Aeasala/p5n5/fleuron.png

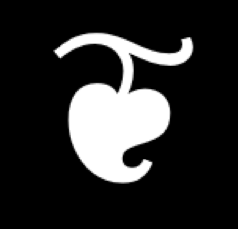
fleuron.png
