Aeasala/p5n5/Project Outputs for p5n5/BOM/Bill of Materials-p5n5.xlsx

Manufacturer | Part Number | Description | Designator | Footprint | Value | Quantity
KEMET | C0805C102J5RACTU | CAP CER 1000PF 50V X7R 0805 | C1, C2 | CAP 0805_2012 | 1000 pF | 2 | C0805C102J5RACTU | 2
KEMET | C0805C224K5RACTU | CAP CER 0.22UF 50V X7R 0805 | C3, C4 | CAP 0805_2012 | 0.22 µF | 2 | C0805C224K5RACTU | 2
TDK Corporation | CGA8P1X7R1E226M250KC | CAP CER 22UF 25V X7R 1812 | C5_N5V, C5_P5V, C6_N5V, C6_P5V, C7_N5V, C7_P5V, C8_N5V, C8_P5V | CAP 1812_4532 1.1MM | 22 µF | 8 | CGA8P1X7R1E226M250KC | 8
KEMET | C1206C475K5RACTU | CAP CER 4.7UF 50V X7R 1206 | C9, C10, C11, C12, C13, C14, C15, C16 | CAP 1206_3216 - 0.8MM | 4.7 µF | 8 | C1206C475K5RACTU | 8
KEMET | T491X686K025AT | CAP TANT 68UF 10% 25V 2917 | C17, C18, C19, C20 | CAP POL 2917_7343 | 68 µF | 4 | T491X686K025AT | 4
Visual Communications Company - VCC | CMD17-21VGD/TR8 | LED GREEN DIFFUSED 0805 SMD | D1 | LED 0805_2012 GREEN | Green | 1 | CMD17-21VGD/TR8 | 1
Visual Communications Company - VCC | CMD17-21VRD/TR8 | LED RED DIFFUSED 0805 SMD | D2 | LED 0805_2012 RED | Red | 1 | CMD17-21VRD/TR8 | 1
Nexperia USA Inc. | PMEG40T30ERX | DIODE SCHOTTKY 40V 3A SOD123W | D3 | SOD-123W |  | 1 | PMEG40T30ERX | 1
 |  |  | FD1, FD2, FD3 | FIDUCIAL |  | 3 | M20-7830642 | 3
Harwin Inc. | M20-7830642 | CONN RCPT 12POS 0.1 GOLD PCB | J1, J2, J4 | HARWIN M20-7830645 |  | 3 | 282834-2 | 1
TE Connectivity AMP Connectors | 282834-2 | TERM BLK 2P SIDE ENT 2.54MM PCB | J3 | TE 282834-2 |  | 1 | 7443634700 | 1
Würth Elektronik | 7443634700 | FIXED IND 47UH 12A 12.2 MOHM SMD | L1 | WURTH WE-HCF 14.5MM | 47 µH | 1 | BC817-40-7-F | 2
Diodes Incorporated | BC817-40-7-F | TRANS NPN 45V 0.5A SOT23-3 | Q1, Q2 | DIODES SOT-23-3 |  | 2 | ERA-8ARW4532V | 1
Panasonic Electronic Components | ERA-8ARW4532V | RES SMD 45.3KOHM 0.05% 1/4W 1206 | R1 | RES 1206_3216 | 45.3 kOhms | 1 | ERJ-PB6B2700V | 1
Panasonic Electronic Components | ERJ-PB6B2700V | RES SMD 270 OHM 0.1% 1/4W 0805 | R2 | RES 0805_2012 | 270 Ohms | 1 | TNPW080551K0BEEA | 1
Vishay Dale | TNPW080551K0BEEA | RES 51K OHM 0.1% 1/8W 0805 | R3 | RES 0805_2012 | 51 kOhms | 1 | TNPW08059K10BEEA | 1
Vishay Dale | TNPW08059K10BEEA | RES 9.1K OHM 0.1% 1/8W 0805 | R4 | RES 0805_2012 | 9.1 kOhms | 1 | RT0805FRE1310KL | 2
Yageo | RT0805FRE1310KL | RES 10K OHM 1% 1/8W 0805 | R6, R7 | RES 0805_2012 | 10 kOhms | 2 | ERA-8AEB8062V | 2
Panasonic Electronic Components | ERA-8AEB8062V | RES SMD 80.6K OHM 0.1% 1/4W 1206 | R8, R9 | RES 1206_3216 | 80.6 kOhms | 2 | RHC2512FT1R00 | 1
Stackpole Electronics Inc | RHC2512FT1R00 | RES 1 OHM 1% 2W 2512 | R10 | RES 2512_6432 | 1 Ohms | 1 | CRCW120647K0FKEA | 1
Vishay Dale | CRCW120647K0FKEA | RES SMD 47K OHM 1% 1/4W 1206 | R11 | RES 1206_3216 | 47 kOhms | 1 | RT1206FRE07150RL | 2
Yageo | RT1206FRE07150RL | RES SMD 150 OHM 1% 1/4W 1206 | R12, R13 | RES 1206_3216 | 150 Ohms | 2 | LTM8049IY | 1
Analog Devices Inc | LTM8049IY | No Description Available | U1 | LTM8049IY_ADI |  | 1
