Aeasala/p5n5/(threads)

Thread 4 (2023-08-04):

perform final spice analyses of project as a whole

Aeasala, 2023-08-04:
verify transient behavior of input filter w SMPS running.

verify stability of converter at various loads with selected amt of bulk capacitance

verify transient load switching/load regulation effect on input and output

monte carlo on input filter?  may be so overdamped that it doesn't matter

Aeasala, 2023-08-04:
Findings 1: pick different filtering inductance or larger input capacitance following it (still not damped enough for my liking)

Aeasala, 2023-08-04:
confirm feedback cap leading to N5V network

Aeasala, 2023-08-05:
Future todo: verify ""optimal"" switching frequency per datasheet for a +/- 5V output.

Closed 2023-08-05.

Thread 5 (2023-08-04):

add freewheeling diode to input inductor

Aeasala, 2023-08-04:
Inrush current to input filter appears to cause overshoot rel to supply voltage.  Flyback diode would clamp just over the supply voltage until settled.

In a second case, if the supply is suddenly disconnected while under load, back-EMF could destroy parts of the circuit.  Back EMF only seems that it would appear at the connector pin, rather than at the capacitor array -- still best-practice, though.

Aeasala, 2023-08-04:
diode should be rated for ~10A during the inrush.

Closed 2023-08-04.

Thread 6 (2023-08-04):

physical switch over run net

Aeasala, 2023-08-04:
To prevent inrush current faults.  3A current limit seems to not be enough for large input capacitance. before the 8049 attempts to begin running.

If physical switch isn't desired, increase SS1/2 delay.

Aeasala, 2023-08-05:
Soft start was increased to a 7.5-15ms margin

Closed 2023-08-05.

Thread 7 (2023-08-04):

Power rate damping resistor

Aeasala, 2023-08-04:
may need to parallel, need ~10W max over a 5ms period.  check pulse ratings

Aeasala, 2023-08-04:
parallelling would be good for the sake of transient response/parasitics

Aeasala, 2023-08-06:
Considering the duration of the inrush to these caps, this is nothing to worry about.  Would only be a problem if someone was connecting/DC-ing+shorting really fast repeatedly (which would be their problem if they broke it tbh)

Closed 2023-08-06.

Thread 15 (2023-08-05):

Fix some component spacing

Aeasala, 2023-08-05:
R1 is too close in proximity to R2/C1.  Confirm BGA dogbone drill size, pad size, spacing, tenting.

Move some (half of) decoupling caps towards the opposing VIN2/VIN1, whichever is which on the footprint?  Would require lopping off some of the P5V plane, as well as stitching a new GND plane in the empty region right of L1.

Closed 2023-08-06.

Thread 16 (2023-08-05):

Increase or verify copper clearance to board edge

Aeasala, 2023-08-05:
Received preliminary boards had copper uncomfortably close to board edge.

Aeasala, 2023-08-06:
This is a non-issue

Closed 2023-08-06.

Thread 18 (2023-08-05):

Pick alternate flyback diode

Aeasala, 2023-08-05:
mfr states part is obsolete.

Aeasala, 2023-08-05:
also, probably do not need DC current rating that high.  look into pulsed current rating.

Closed 2023-08-06.

Thread 30 (2023-08-15):

Audible coil whine under small load

Aeasala, 2023-08-15:
from umodule

Aeasala, 2023-09-05:
appears to be from my poor BGA soldering.  regardless, will create another issue to change switching frequency to the recommended 100 kHz for a bipolar 5V output.

Closed 2023-09-05.

Thread 33 (2023-08-15):

Replace fiducials with mounting holes

Aeasala, 2023-08-15:
Fiducials originally included as proof-of-concept.  Switch to mounting holes (+1 additional corner) for standoffs/pegs to elevate on a surface
