Aeasala/p5n5/Project Outputs for p5n5/Schematic.PDF

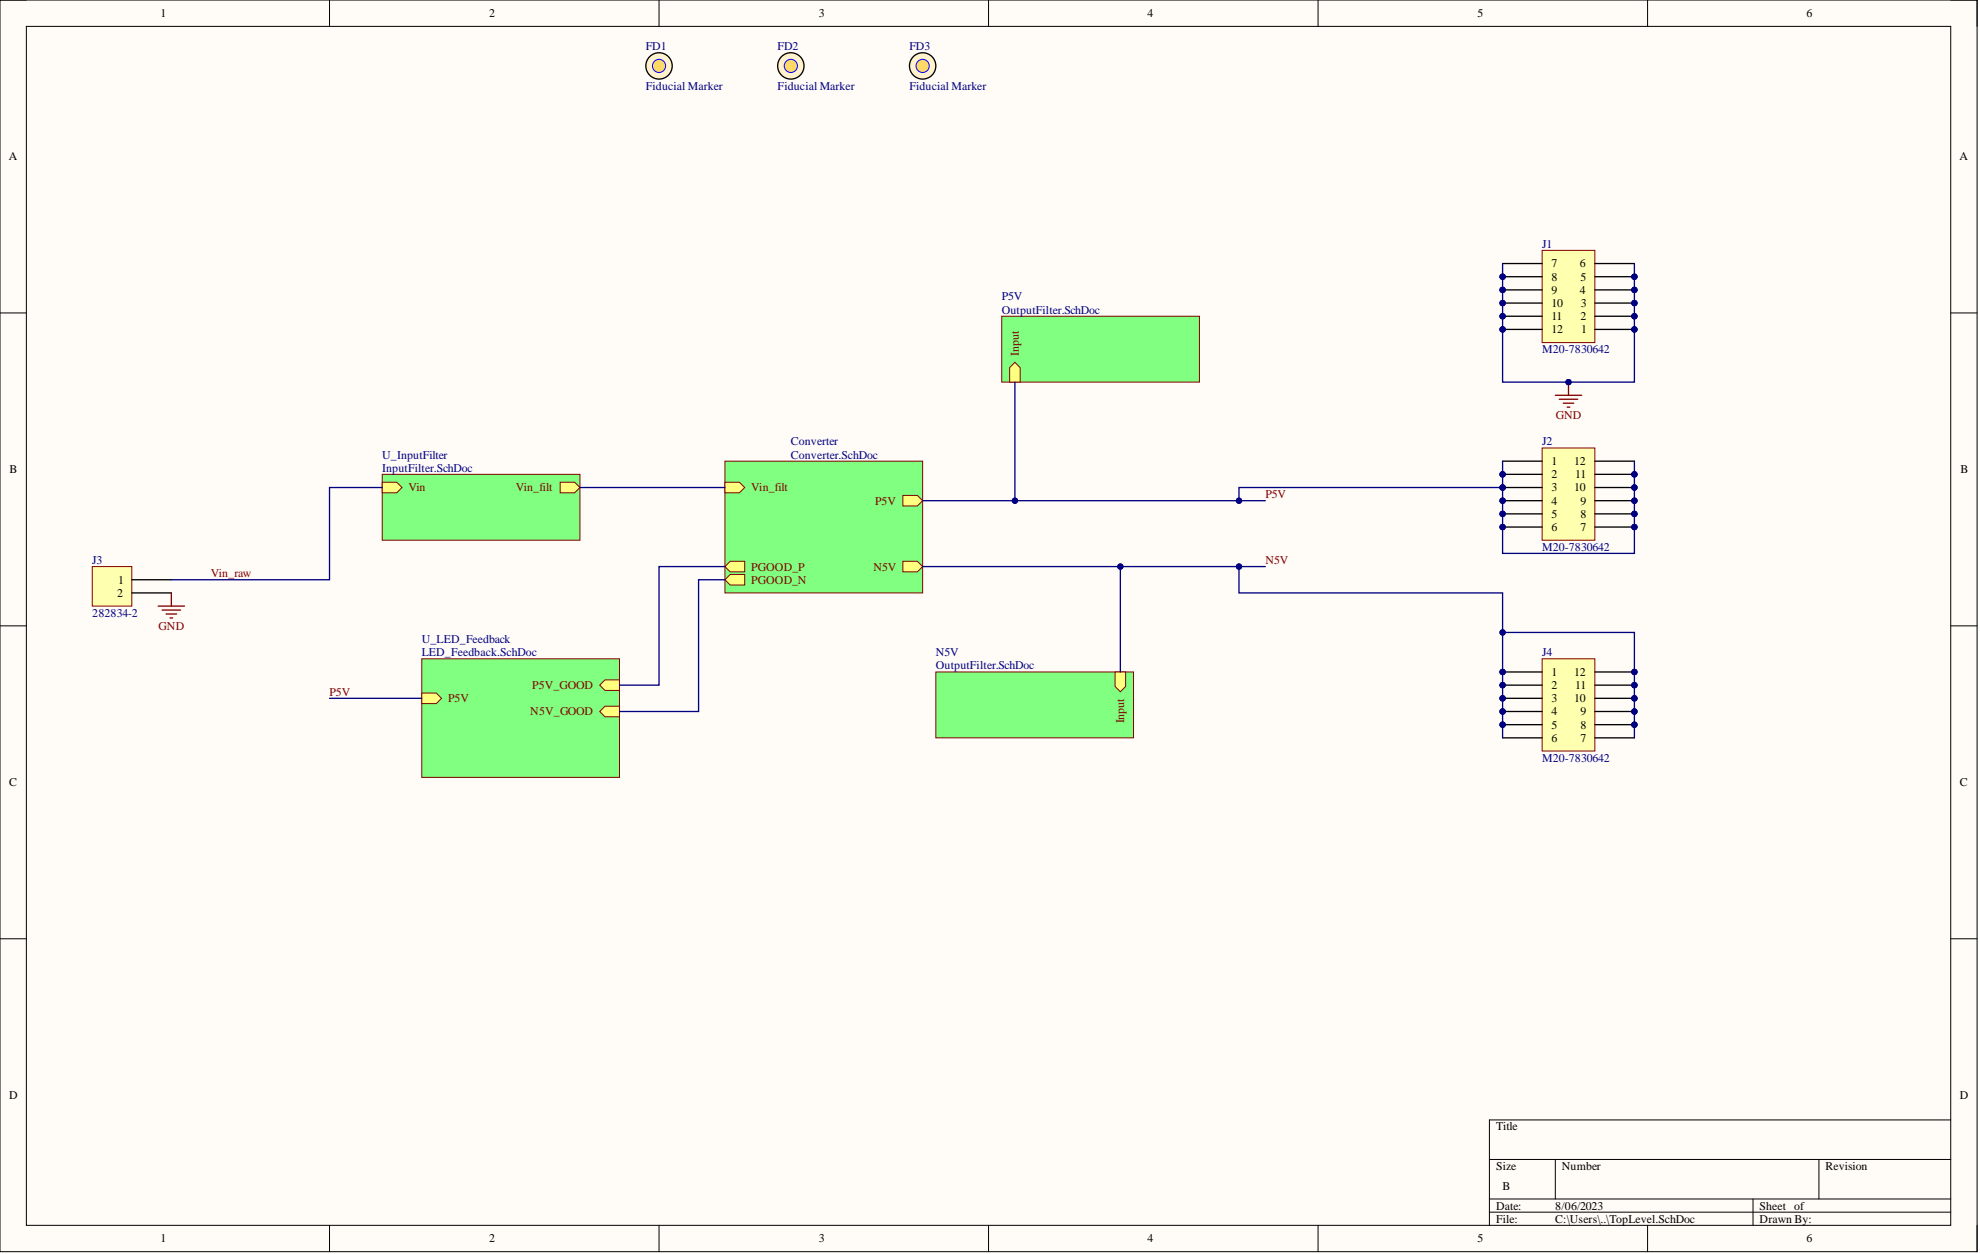
[picture p2: page 1]

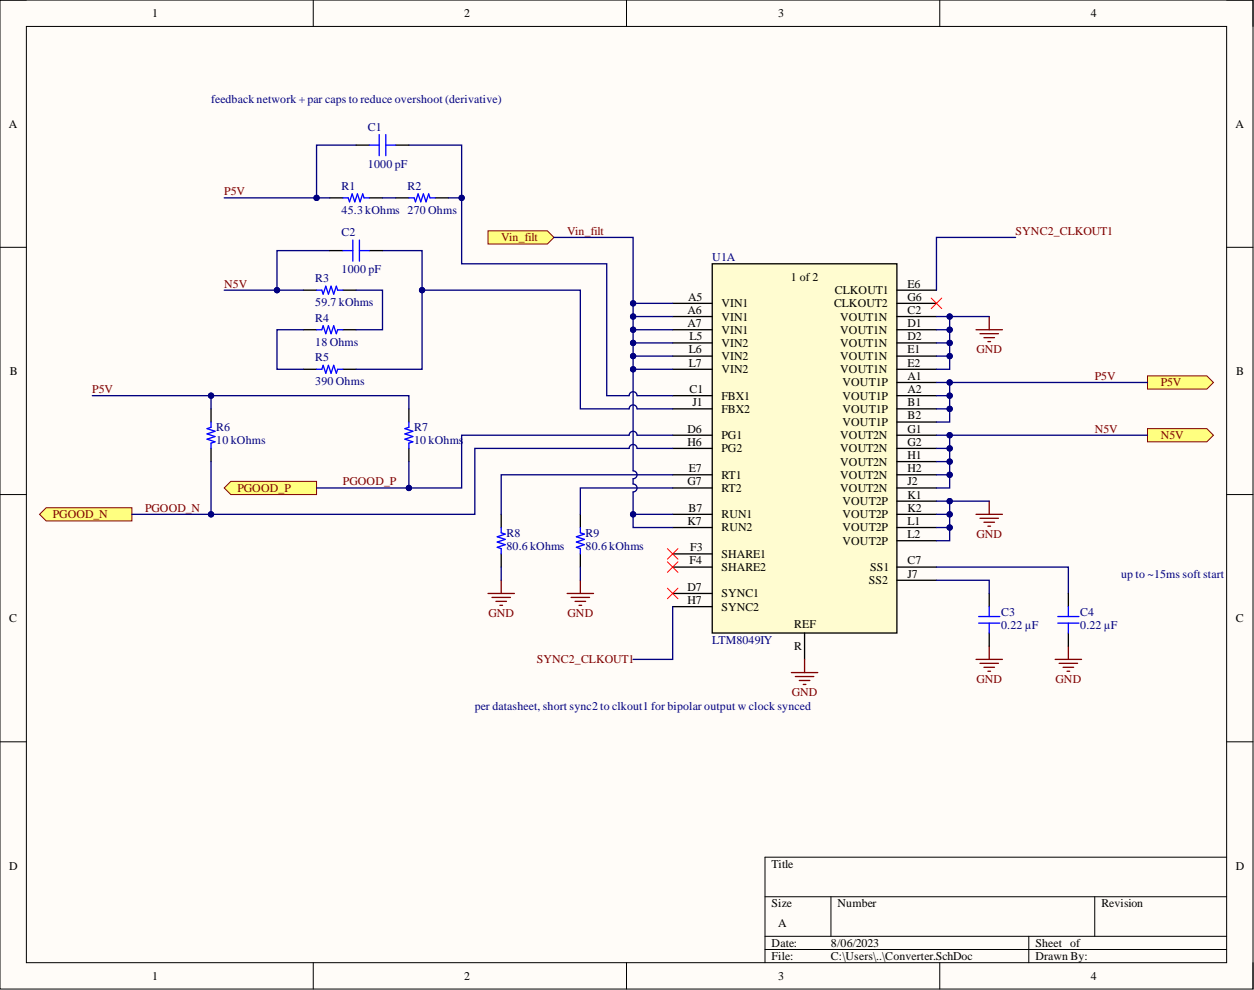
[picture p3: page 2]

feedback network + par caps to reduce overshoot (derivative)

VIN1 A6
VIN1 A7
VIN2 L5
VIN2 L6

RUN1 B7

per datasheet, short sync2 to clkout1 for bipolar output w clock synced

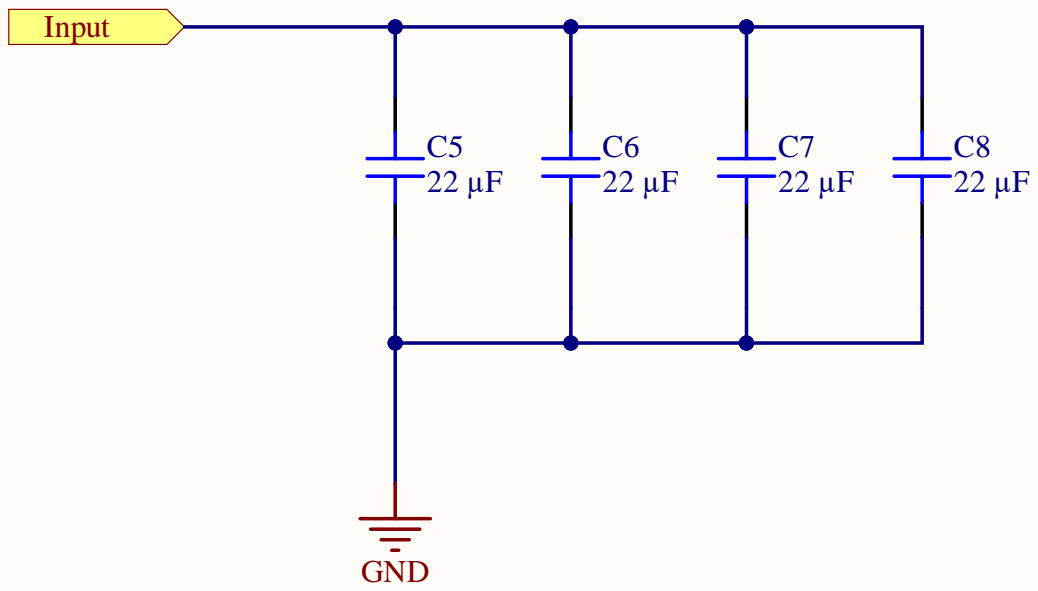
[picture p4: page 3]

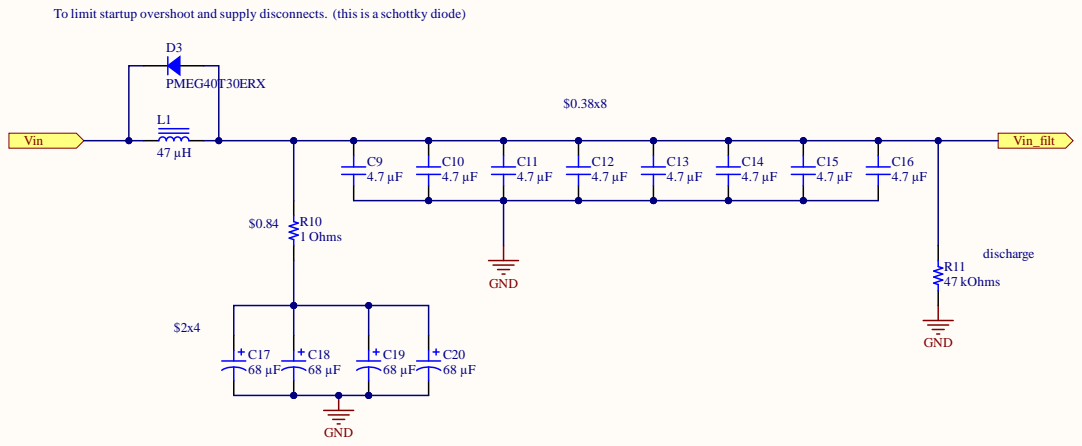
[picture p5: page 4]

To limit startup overshoot and supply disconnects. (this is a schottky diode)

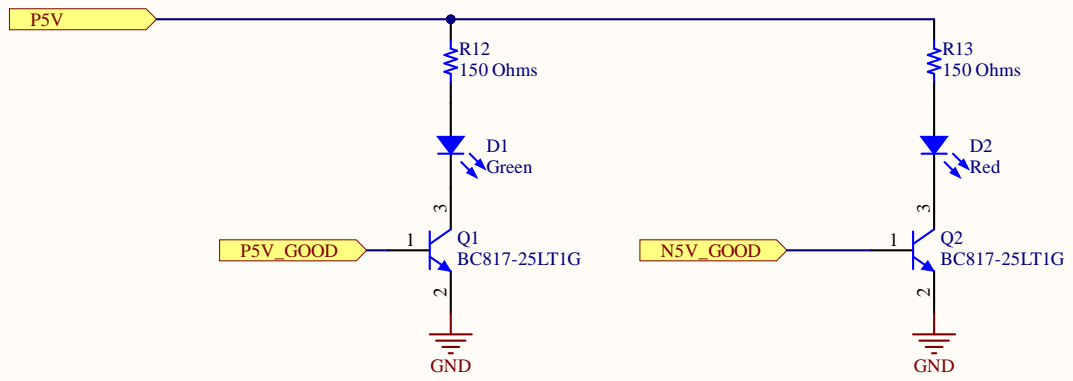
[picture p6: page 5]
