Aeasala/p5n5/Project Outputs for p5n5/PCB.PDF

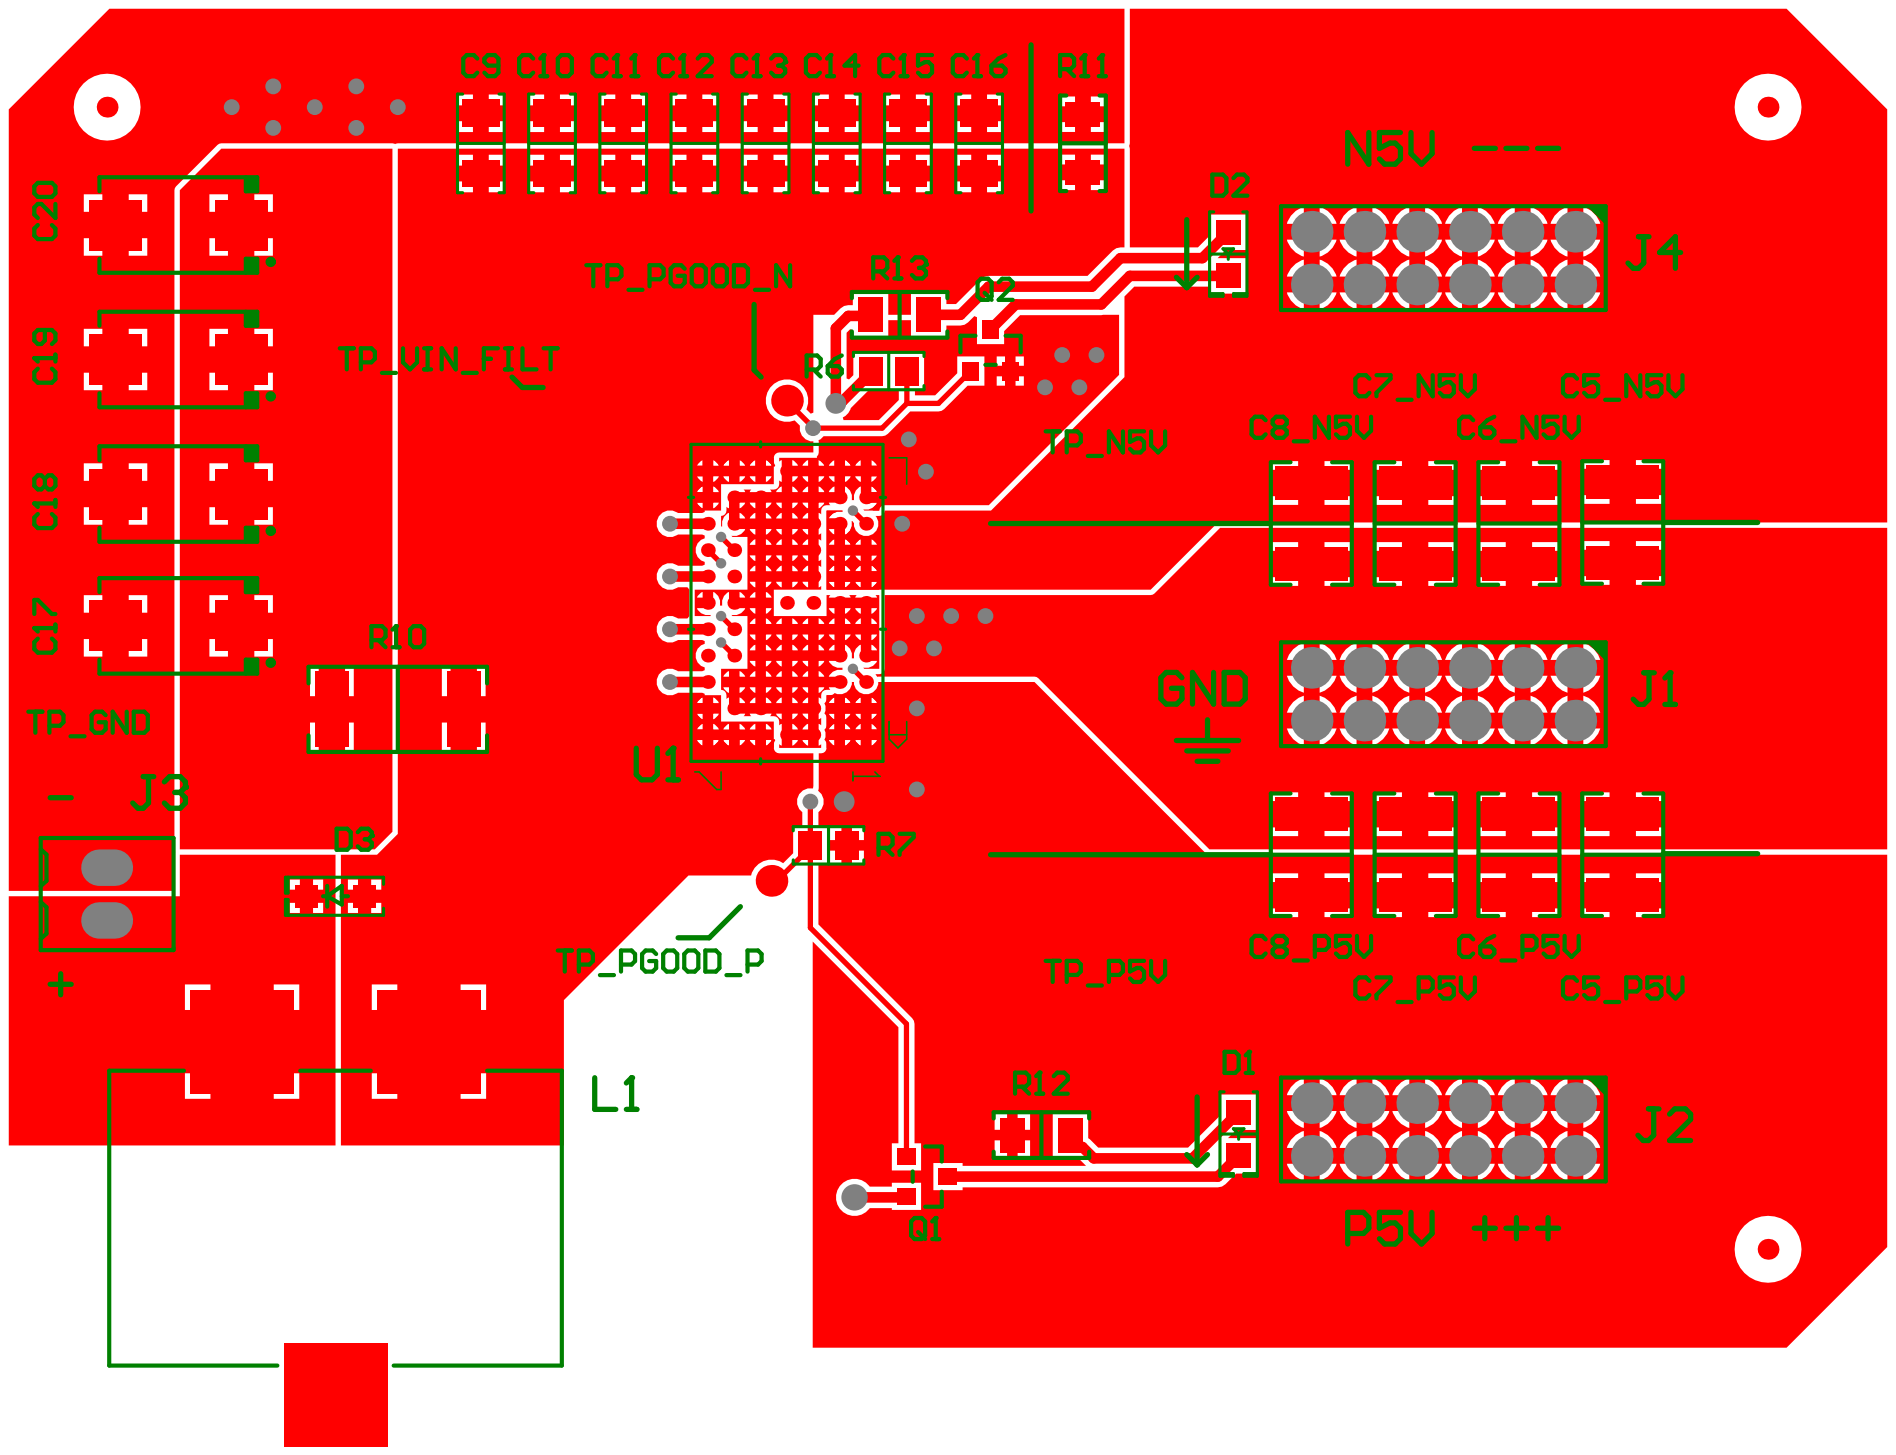
[picture p7: page 1]

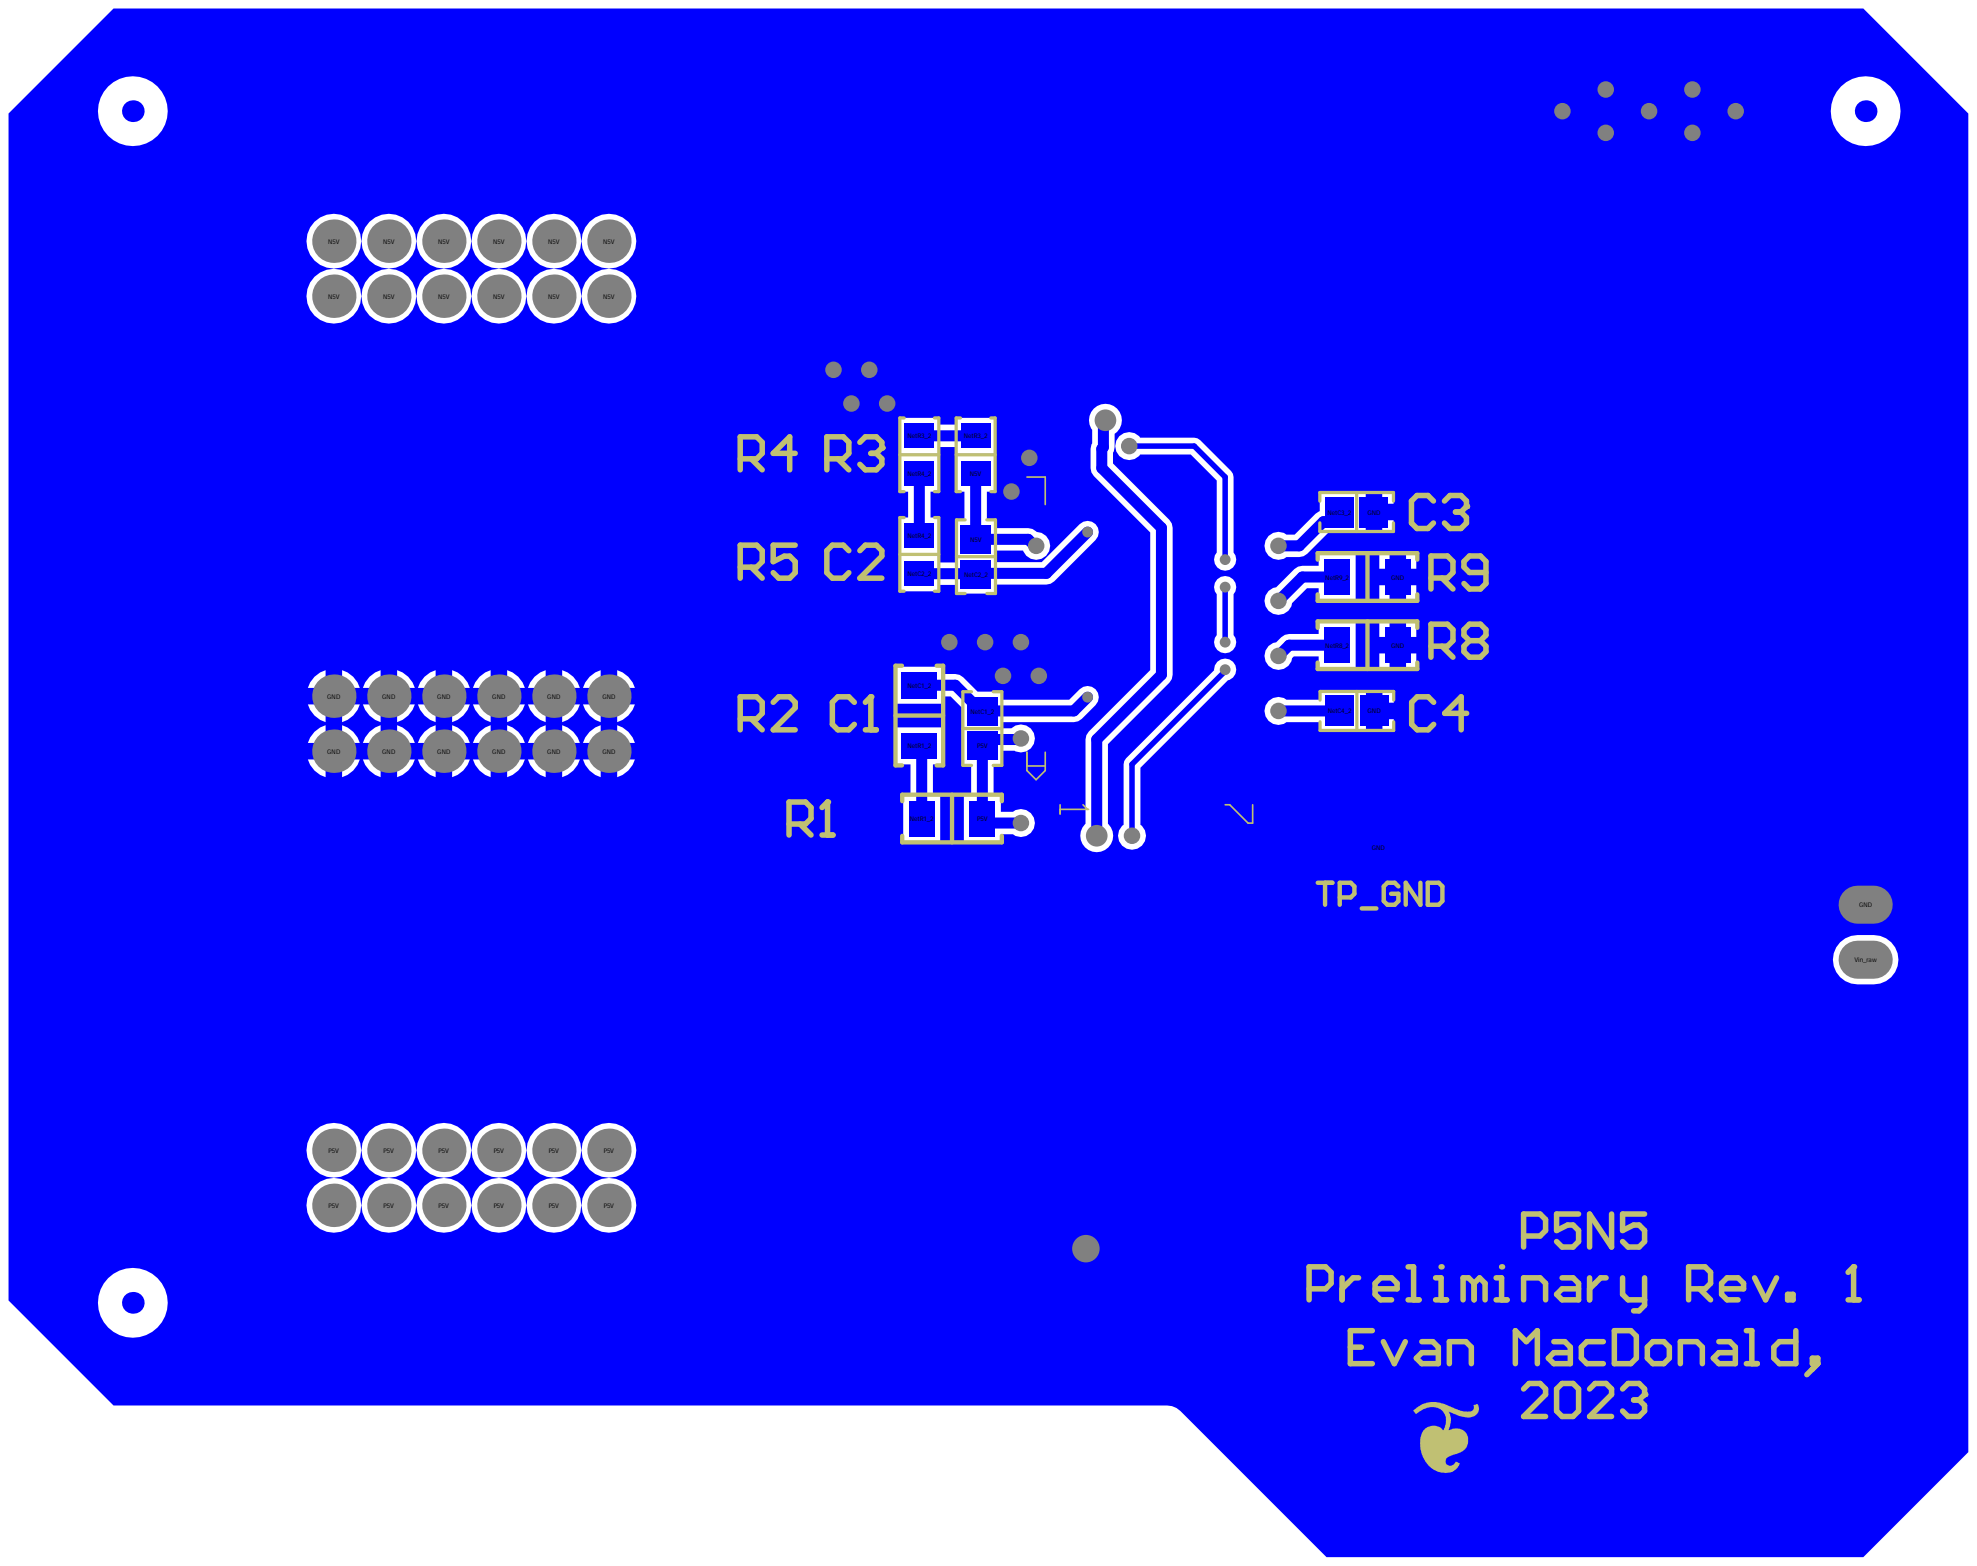
[picture p8: page 2]

NetC3_2 | GND

NetR4_2

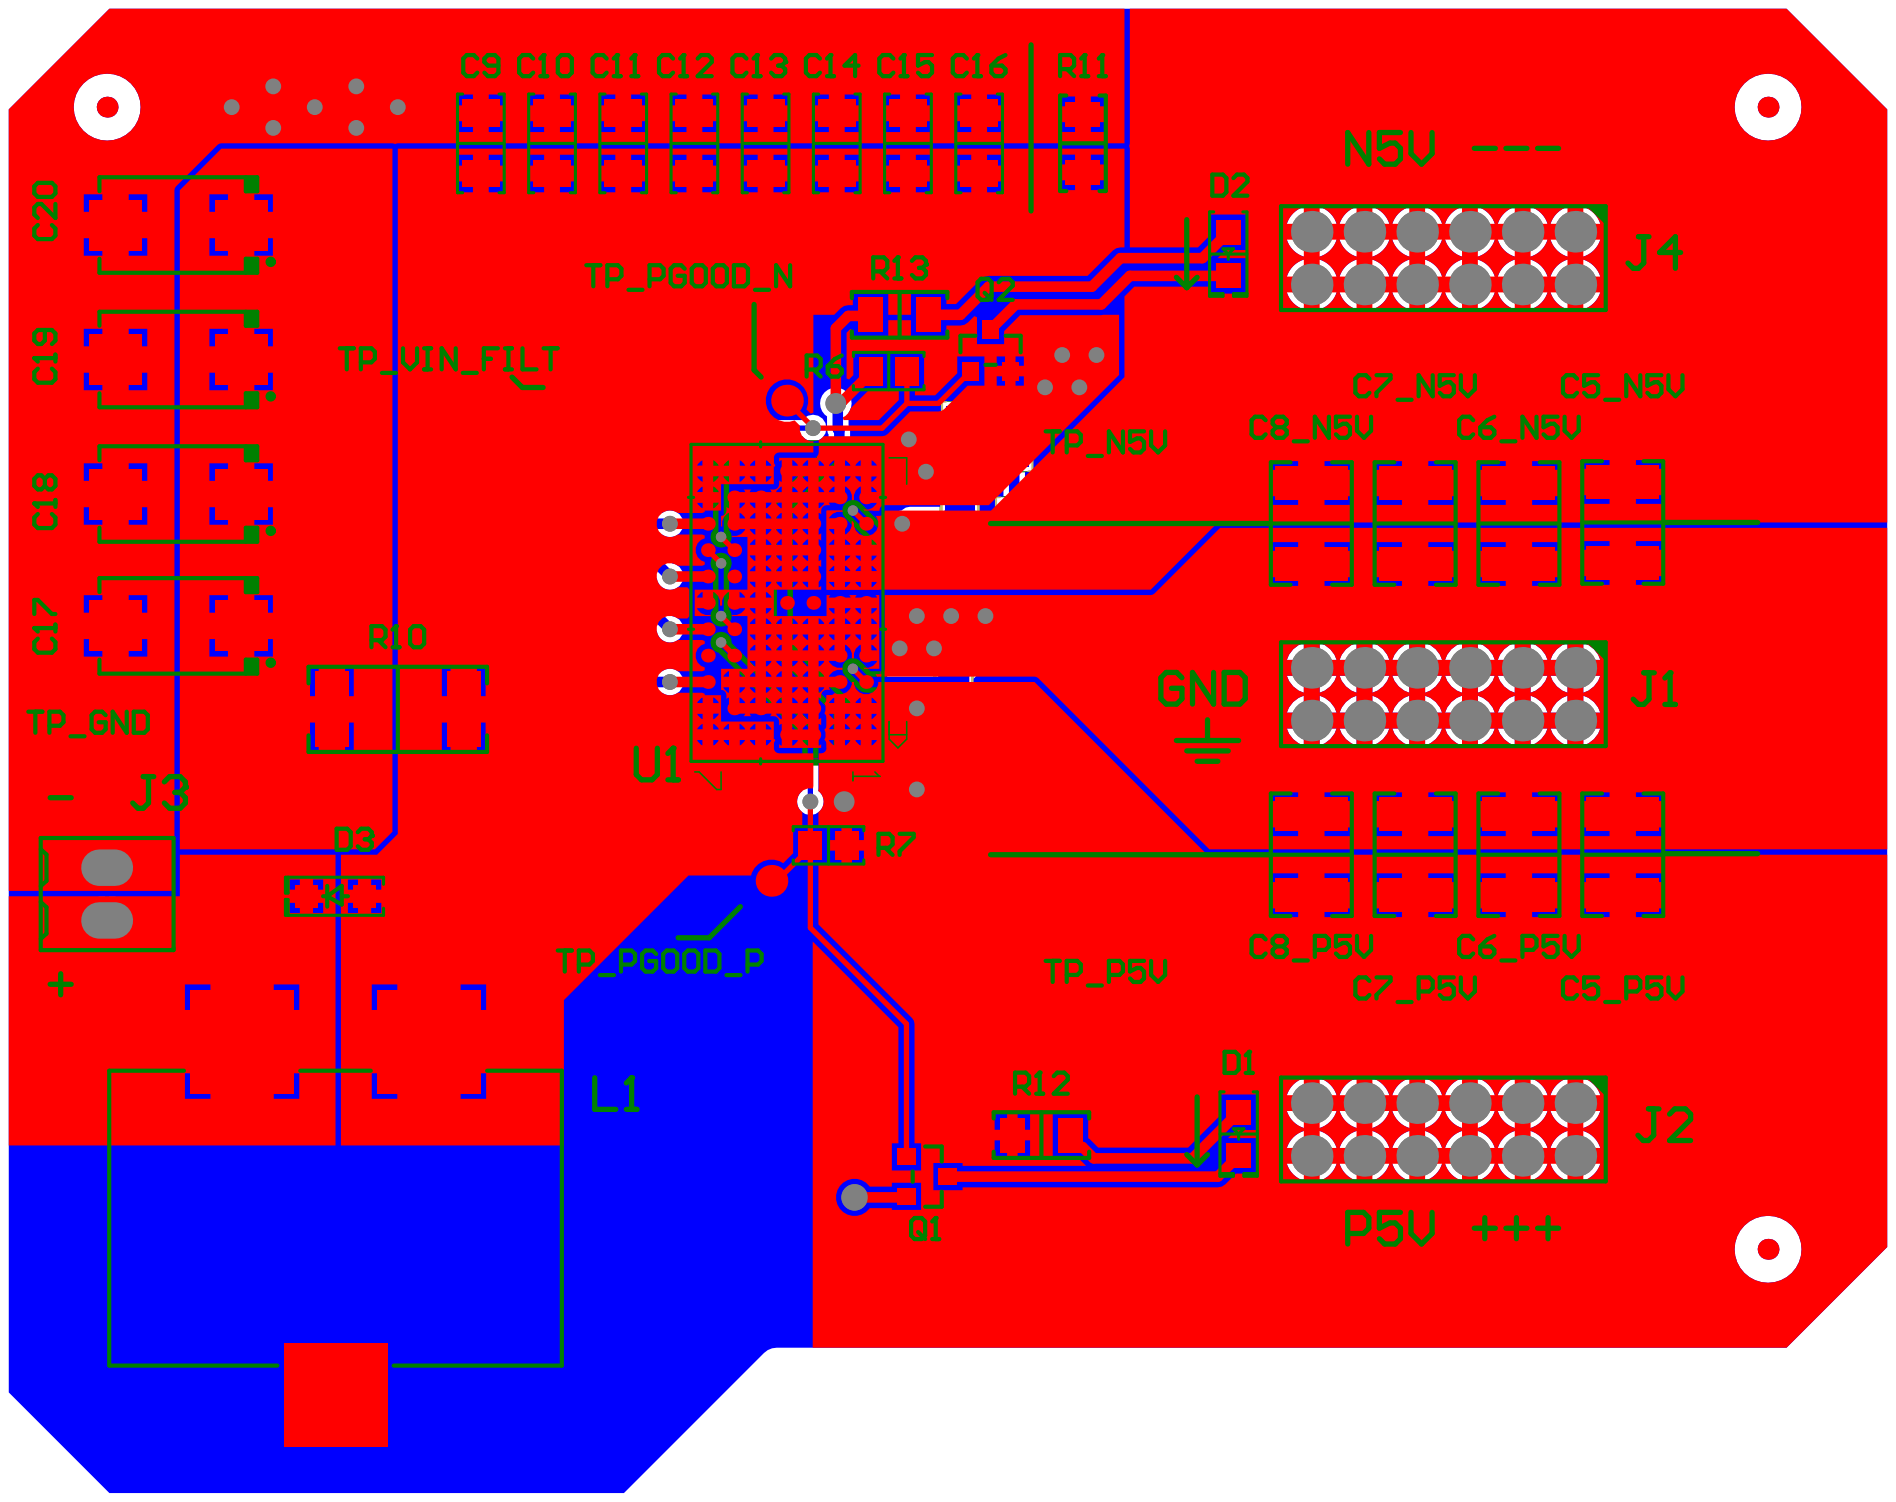
[picture p9: page 3]

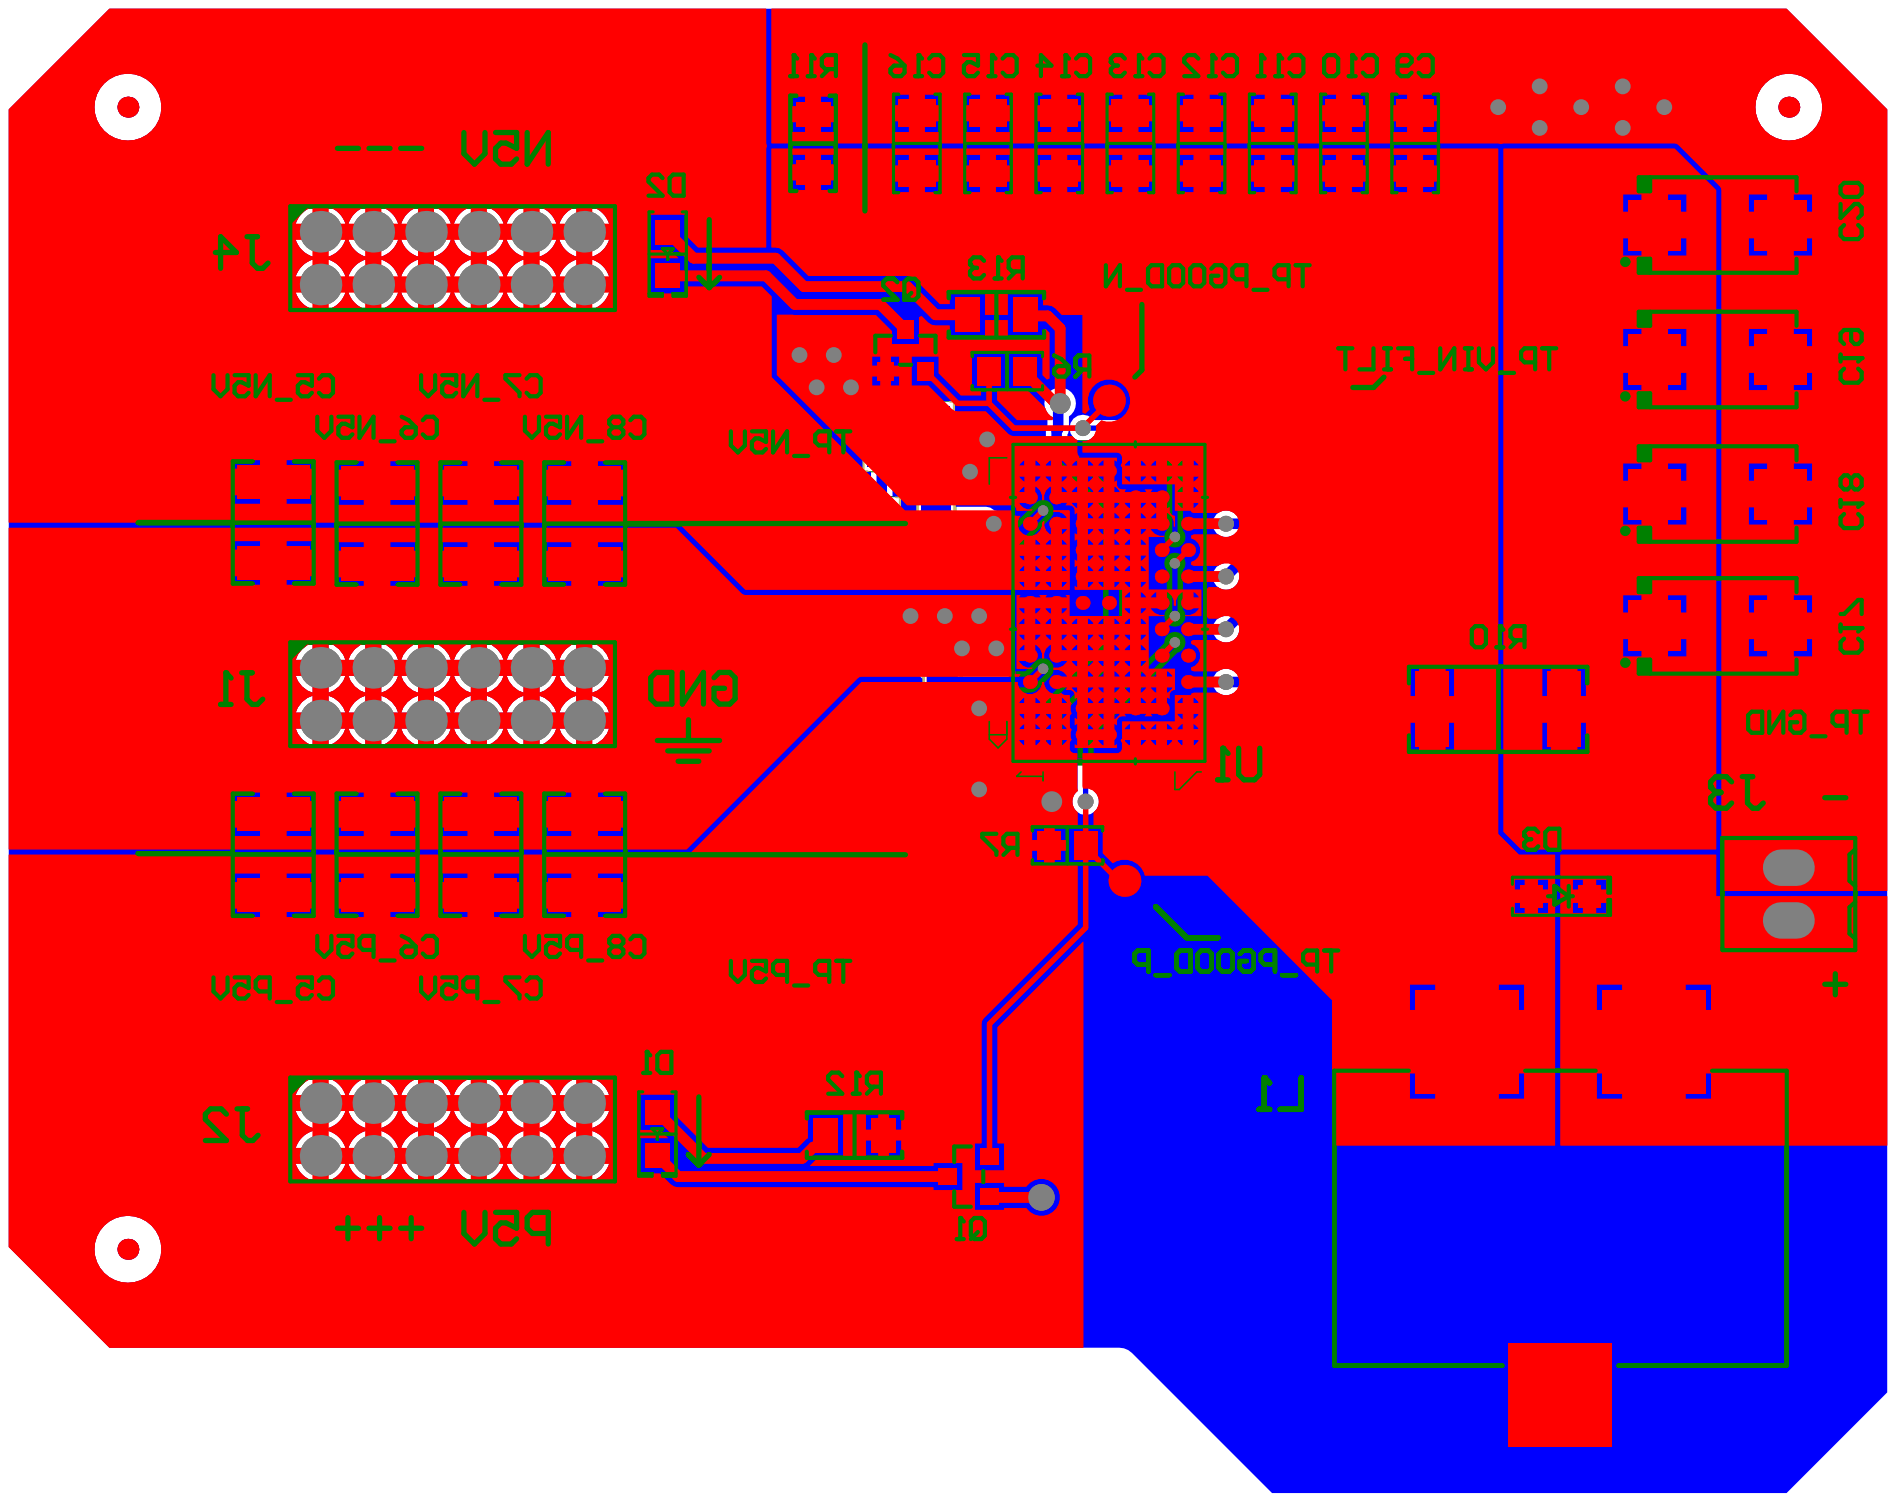
[picture p10: page 4]
