Aeasala/p5n5/lts/compound_sim_stability.asc

@1: fra; delay=1.1m fstart=90.0844 fend=100K oct=4 fcoarse=720.675 nmax=2 pp0=160.416m pp1=10.026m f0=90.0844 f1=1.44135K tavgmin=100µ tsettle=693.794µ
@2: fra; delay=1.1m fstart=90.0844 fend=100K oct=4 fcoarse=720.675 nmax=2 pp0=160.96m pp1=10.06m f0=90.0844 f1=1.44135K tavgmin=100µ tsettle=693.794µ
C1: polcap; T491X686K025AT; Rser=700m
C2: cap; C1206C475K5RACTU
C3: cap; 22µ
C4: cap; 22µ
C5: cap; {SSnorm}
C6: cap; {SSnorm}
C7: cap; 1n
C8: cap; 1n
C9: cap; 22µ
C10: cap; 22µ
C11: cap; 22µ
C12: cap; 22µ
C13: cap; 22µ
C14: cap; 22µ
C27: cap; C1206C475K5RACTU
C28: cap; C1206C475K5RACTU
C29: cap; C1206C475K5RACTU
C30: cap; C1206C475K5RACTU
C31: cap; C1206C475K5RACTU
C32: cap; C1206C475K5RACTU
C33: cap; C1206C475K5RACTU
C34: polcap; T491X686K025AT; Rser=700m
C35: polcap; T491X686K025AT; Rser=700m
C36: polcap; T491X686K025AT; Rser=700m
D1: LED; LXZ1-PB01
D3: schottky; RBR15BGE30A
D4: LED; LXZ1-PB01
Q1: BC817-40
Q2: BC817-40
R1: res; 80.6K
R2: res; 80.6K
R3: res; 45.570k
R4: res; 60.108k
R5: res; 10k
R6: res; 1
R7: res; 10k
R8: res; 47k
R9: res; 150
R10: res; 150
R11: res; 5
R12: res; 5
U1: LTM8049
U2: 
U3: 
U4: WE-HCF
V1: voltage; {vin}
V2: voltage; PWL(1m 100k 1.001m 5 1.05m 10 1.5m 10 1.501m 100 2m 100 2.001m 5 2.5m 5 2.501m 100k 4m 10)
V3: voltage; PWL(1m 100k 1.001m 5 1.05m 10 1.5m 10 1.501m 100 2m 100 2.001m 5 2.5m 5 2.501m 100k 4m 10)
V4: voltage; 2
V5: voltage; 2
Named nets: 0, Vin, P5V, N5V, pgood1, pgood2, Vin_filt, load_p, load_n, SS1, SS2, Vdamp, fbP, fbN
NC_X
NC_X
.fra tstart=1m uic
use -iy because SnPb is easy to melt
2.0-2.4 Vf @ 20mA
;.step param vin list 2.6 5 10 12 16
.SUBCKT C1206C475K5RACTU 1 6
*Temp = 25°C, Bias = 0VDC, Center Frequency = 4000 Hz
*KEMET Model RLC Cerm
R1 3 4 0.192140857999481
R2 2 5 0.779999971389771
R3 1 6 212800000
L1 1 2 3.65000027399974E-11
L2 2 3 6.93500052059951E-10
C1 4 6 4.58494306095845E-06
C2 5 6 2.09999990463257E-12
.ENDS
modeled @4khz, around filter resonant area
.SUBCKT T491X686K025AT 1 8
*Temp = 25°C, Bias = 0VDC, Center Frequency = 4000 Hz
*KEMET Model RLC Tant5RC
R1 2 3 0.0578946887614398
R2 3 4 0.0289473443807199
R3 4 5 0.0289473443807199
R4 5 6 0.0289473443807199
R5 6 7 0.0289473443807199
R6 2 8 1471000
L1 1 2 2.29999996825825E-09
C1 3 8 2.19354838709677E-06
C2 4 8 4.38709677419355E-06
C3 5 8 8.7741935483871E-06
C4 6 8 1.75483870967742E-05
C5 7 8 3.50967741935484E-05
.ENDS
Closest match
Input Filtering
Converter
SS1/SS2 will trigger switching at ~400mV
Switching current is limited until they reach 2V
Load switching tests
no current limit for this test.  assuming ideal supply, only observing effects from feedback injection
most stability analyses i have seen put the FRA component directly following the output leading to the FB network.
.param SSnorm 220n
.param SSskip 1p
fsw for this Rt value is 1MHz
trise from 100k to 5ohm load snap is 121.4137us 10/90
approx loop bandwidth is 2882.7Hz
.ic V(Vin_filt)={vin} V(Vdamp)={vin} V(P5V)=3.5 V(N5V)=-5.067 V(SS1)=1.5 V(SS2)=1.5 V(fbP)=1.2 V(fbN)=-.0087
.param vin 16
