Aeasala/p5n5/lts/infilt_ac.asc

C9: cap; C1206C475K5RACTU
C10: cap; C1206C475K5RACTU
C11: cap; C1206C475K5RACTU
C12: cap; C1206C475K5RACTU
C13: cap; C1206C475K5RACTU
C14: cap; C1206C475K5RACTU
C15: cap; C1206C475K5RACTU
C16: cap; C1206C475K5RACTU
C17: polcap; T491X686K025AT; Rser=700m
C18: polcap; T491X686K025AT; Rser=700m
C19: polcap; T491X686K025AT; Rser=700m
C20: polcap; T491X686K025AT; Rser=700m
D1: schottky; RBR15BGE30A
R1: res; 47k
R11: res; 1
U1: WE-HCF
V1: voltage; ""; AC 1
Named nets: 0, Vin, Vin_filt
step input voltage
.SUBCKT C1206C475K5RACTU 1 6
*Temp = 25°C, Bias = 0VDC, Center Frequency = 4000 Hz
*KEMET Model RLC Cerm
R1 3 4 0.192140857999481
R2 2 5 0.779999971389771
R3 1 6 212800000
L1 1 2 3.65000027399974E-11
L2 2 3 6.93500052059951E-10
C1 4 6 4.58494306095845E-06
C2 5 6 2.09999990463257E-12
.ENDS
.ac dec 3600 1 1Meg
modeled @4khz, around filter resonant area
.SUBCKT T491X686K025AT 1 8
*Temp = 25°C, Bias = 0VDC, Center Frequency = 4000 Hz
*KEMET Model RLC Tant5RC
R1 2 3 0.0578946887614398
R2 3 4 0.0289473443807199
R3 4 5 0.0289473443807199
R4 5 6 0.0289473443807199
R5 6 7 0.0289473443807199
R6 2 8 1471000
L1 1 2 2.29999996825825E-09
C1 3 8 2.19354838709677E-06
C2 4 8 4.38709677419355E-06
C3 5 8 8.7741935483871E-06
C4 6 8 1.75483870967742E-05
C5 7 8 3.50967741935484E-05
.ENDS
Closest match
