Aeasala/p5n5/lts/eqled.asc

D1: LED; PT-121-B
D2: LED; L1C1-CYN1000000000
D3: LED; L1C1-GRN1000000000
D4: LED; LXZ1-PB01
I1: current; 20m
I2: current; 20m
I3: current; 20m
I4: current; 20m
Named nets: 0
.tran 1m
lo
hi
