Aeasala/p5n5/(list of files, drawings)

Other design files:
Board_Single.PcbDoc
Converter.SchDoc
InputFilter.SchDoc
LED_Feedback.SchDoc
LTM8049IY.PcbLib
LTM8049IY.SchLib
OutputFilter.SchDoc
p5n5.PrjPcb
TopLevel.SchDoc
