Aeasala/p5n5/(commit log)

2023-08-04 Initial commit & push
    [Board_Single.PcbDoc, Converter.SchDoc, InputFilter.SchDoc, LED_Feedback.SchDoc, LTM8049IY.PcbLib, LTM8049IY.SchLib, OutputFilter.SchDoc, TopLevel.SchDoc]
2023-08-04 Increase thermal relief widths, correct fiducial clearances. Add graphic and signature.
    [Board_Single.PcbDoc, TopLevel.SchDoc, p5n5.PrjPcb]
2023-08-04 Add Schematic.PDF and PCB.PDF
2023-08-04 Add spice sim
    [Board_Single.PcbDoc]
2023-08-04 Added schottky-type flyback.
    [Board_Single.PcbDoc, InputFilter.SchDoc]
2023-08-04 replace c3, c4 to 220nF (~15ms soft start worst case, 7.5ms lowest worst case, enough for 3A supply limitation)
    [Board_Single.PcbDoc, Converter.SchDoc]
2023-08-04 add standalone input filter sim
2023-08-04 add ac simulation of input filter
2023-08-04 Carry over input filter work to compound_sim.asc
2023-08-05 D3 shall be SS2P5-M3/84A
    [InputFilter.SchDoc, p5n5.PrjPcb]
2023-08-05 Implement on board and correct annotation
    [Board_Single.PcbDoc, InputFilter.SchDoc]
2023-08-06 Finalize polygon/thermal relief fitting
    [Board_Single.PcbDoc]
2023-08-06 Opt cheaper, proper alternative to R11
    [InputFilter.SchDoc]
2023-08-06 Picked more readily available and/or cheaper components, sticking generally with KEMET for caps.
    [Board_Single.PcbDoc, Converter.SchDoc]
2023-08-06 Change flyback diode once again.
    [Board_Single.PcbDoc, InputFilter.SchDoc]
2023-08-06 Move R1 to increase space around neighbors
    [Board_Single.PcbDoc]
2023-08-06 Change to PMEG diode in LTS analysis, fix spacing in mentioned components.
    [Board_Single.PcbDoc]
2023-08-06 Reorganized. may change in future
    [Board_Single.PcbDoc]
2023-08-06 Primary action: mark BGA dogbone vias as tented.
    [Board_Single.PcbDoc]
2023-08-07 Changes to feedback network components.
    [Converter.SchDoc]
2023-08-07 implement new components on board
    [Board_Single.PcbDoc, Converter.SchDoc]
2023-08-07 Change BC817 to one of higher dc current gain and better availability.
    [Board_Single.PcbDoc, LED_Feedback.SchDoc]
2023-08-07 Final changes.
    [Converter.SchDoc, p5n5.PrjPcb]
2023-08-08 Change C1/2/3/4/9-16 part numbers to make Mouser-friendly. RAC7800 has enormous MOQ compared to RACTU on Mouser. Latter P/N not available directly through Celestial, just making exception here.
    [Board_Single.PcbDoc, Converter.SchDoc, InputFilter.SchDoc]
2023-08-08 Add BOM.
    [Bill of Materials-p5n5.xlsx]
2023-08-08 Rev A finished.
    [Board_Single.PcbDoc]
2023-08-15 Add litecompound_LED.asc. Use BC807-40 PNP complement to utilize N5V for LED feedback.
